nthpulse/mrom64c/README.md

# mrom64c
char and kernal rom replacement for the c64 250469 board

part of the MROM64 project: https://nthpulse.net/projects/mrom64/

details & instruction for this circuit board:
https://nthpulse.net/projects/mrom64/boards/mrom64c/
