nthpulse/mrom64c/MROM64C.kicad_pcb

## KiCad design MROM64C.kicad_pcb (2026-03-04)

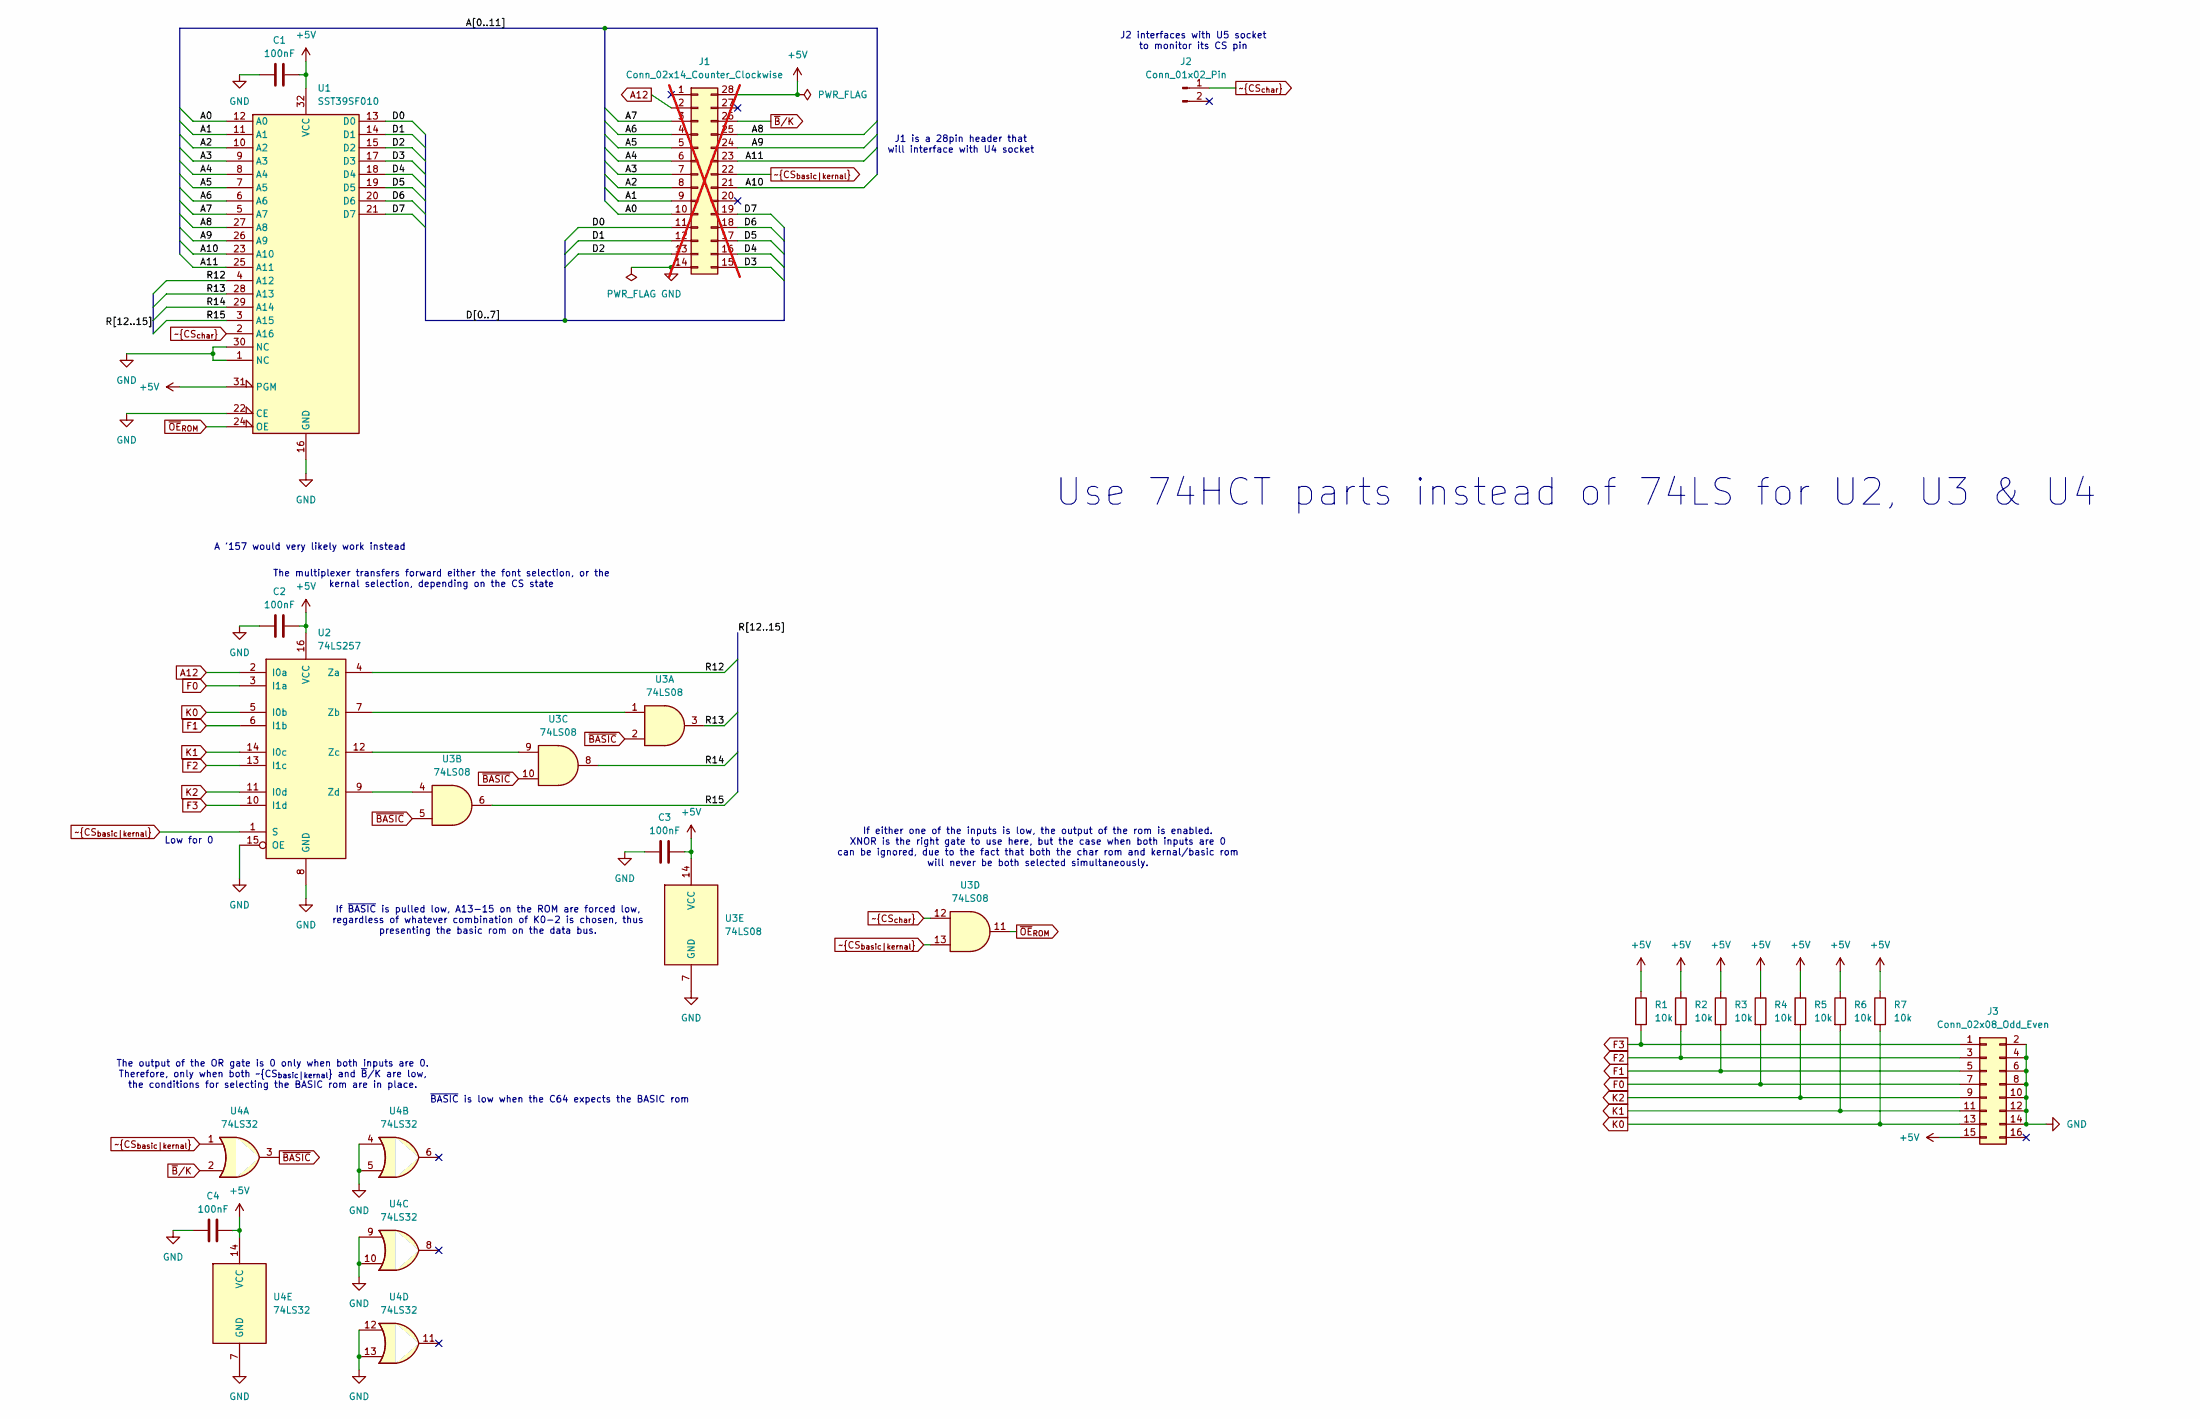
[picture p1: schematic MROM64C.kicad_sch]

Parts:
C1, C2, C3, C4: 100nF; C_0805_2012Metric_Pad1.18x1.45mm_HandSolder
J1: Conn_02x14_Counter_Clockwise; DIP-28_W15.24mm; not fitted
J2: Conn_01x02_Pin; PinHeader_1x02_P2.54mm_Vertical
J3: Conn_02x08_Odd_Even; PinHeader_2x08_P2.54mm_Vertical
R1, R2, R3, R4, R5, R6, R7: 10k; R_0805_2012Metric_Pad1.15x1.40mm_HandSolder
U1: SST39SF010; DIP-32_W15.24mm_Socket
U2: 74LS257; SOIC-16_3.9x9.9mm_P1.27mm
U3: 74LS08; SOIC-14_3.9x8.7mm_P1.27mm
U4: 74LS32; SOIC-14_3.9x8.7mm_P1.27mm

Connections:
+5V: C1.2, C2.2, C3.2, C4.2, J1.28, J3.15, R1.1, R2.1, R3.1, R4.1, R5.1, R6.1, R7.1, U1.31 (PGM), U1.32 (VCC), U2.16 (VCC), U3.14 (VCC), U4.14 (VCC)
/A0: J1.10, U1.12 (A0)
/A1: J1.9, U1.11 (A1)
/A2: J1.8, U1.10 (A2)
/A3: J1.7, U1.9 (A3)
/A4: J1.6, U1.8 (A4)
/A5: J1.5, U1.7 (A5)
/A6: J1.4, U1.6 (A6)
/A7: J1.3, U1.5 (A7)
/A8: J1.25, U1.27 (A8)
/A9: J1.24, U1.26 (A9)
/A10: J1.21, U1.23 (A10)
/A11: J1.23, U1.25 (A11)
/D0: J1.11, U1.13 (D0)
/D1: J1.12, U1.14 (D1)
/D2: J1.13, U1.15 (D2)
/D3: J1.15, U1.17 (D3)
/D4: J1.16, U1.18 (D4)
/D5: J1.17, U1.19 (D5)
/D6: J1.18, U1.20 (D6)
/D7: J1.19, U1.21 (D7)
/R12: U1.4 (A12), U2.4 (Za)
/R13: U1.28 (A13), U3.3
/R14: U1.29 (A14), U3.8
/R15: U1.3 (A15), U3.6
A12: J1.2, U2.2 (I0a)
F0: J3.7, R4.2, U2.3 (I1a)
F1: J3.5, R3.2, U2.6 (I1b)
F2: J3.3, R2.2, U2.13 (I1c)
F3: J3.1, R1.2, U2.10 (I1d)
GND: C1.1, C2.1, C3.1, C4.1, J1.14, J3.2, J3.4, J3.6, J3.8, J3.10, J3.12, J3.14, U1.1 (NC), U1.16 (GND), U1.22 (CE), U1.30 (NC), U2.8 (GND), U2.15 (OE), U3.7 (GND), U4.4, U4.5, U4.7 (GND), U4.9, U4.10, U4.12, U4.13
K0: J3.13, R7.2, U2.5 (I0b)
K1: J3.11, R6.2, U2.14 (I0c)
K2: J3.9, R5.2, U2.11 (I0d)
unnamed: U2.7 (Zb), U3.1
unnamed: U2.12 (Zc), U3.9
unnamed: U2.9 (Zd), U3.4
~BASIC: U3.2, U3.5, U3.10, U4.3
~B/K: J1.26, U4.2
~CS_{basic|kernal}: J1.22, U2.1 (S), U3.13, U4.1
~CS_{char}: J2.1, U1.2 (A16), U3.12
~OE_{ROM}: U1.24 (OE), U3.11

Notes on the sheet:
If either one of the inputs is low, the output of the rom is enabled. XNOR is the right gate to use here, but the case when both inputs are 0 can be ignored, due to the fact that both the char rom and kernal/basic rom will never be both selected simultaneously.
J2 interfaces with U5 socket to monitor its CS pin
The output of the OR gate is 0 only when both inputs are 0. Therefore, only when both ~{CS_{basic|kernal}} and ~{B}/K are low, the conditions for selecting the BASIC rom are in place.
~{BASIC} is low when the C64 expects the BASIC rom
If ~{BASIC} is pulled low, A13-15 on the ROM are forced low, regardless of whatever combination of K0-2 is chosen, thus presenting the basic rom on the data bus.
Use 74HCT parts instead of 74LS for U2, U3 & U4
A '157 would very likely work instead
Low for 0
J1 is a 28pin header that will interface with U4 socket
The multiplexer transfers forward either the font selection, or the kernal selection, depending on the CS state

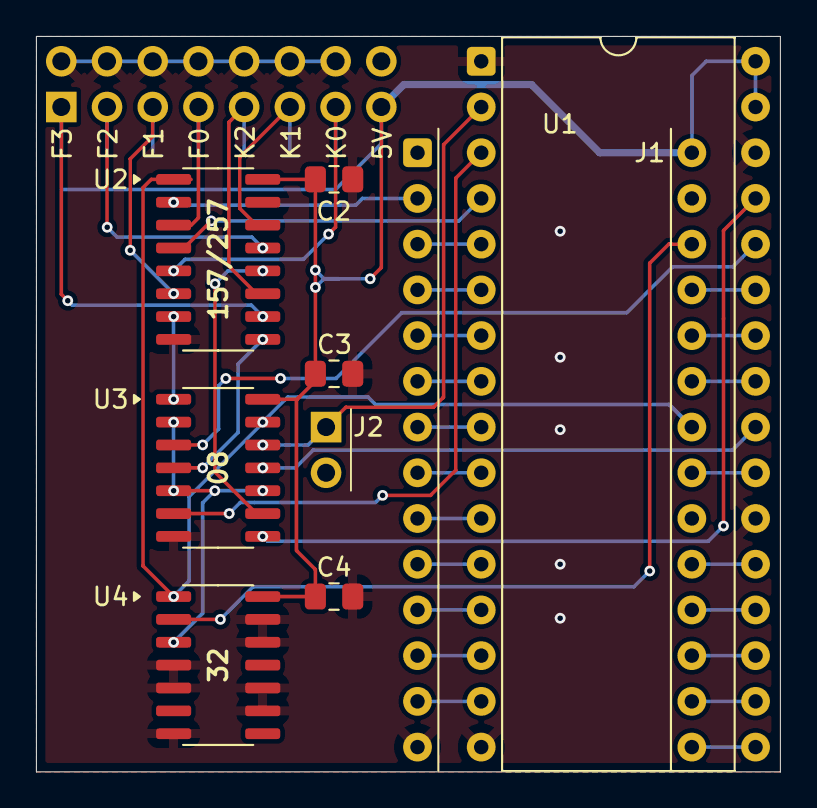
[picture p2: board MROM64C.kicad_pcb from above]

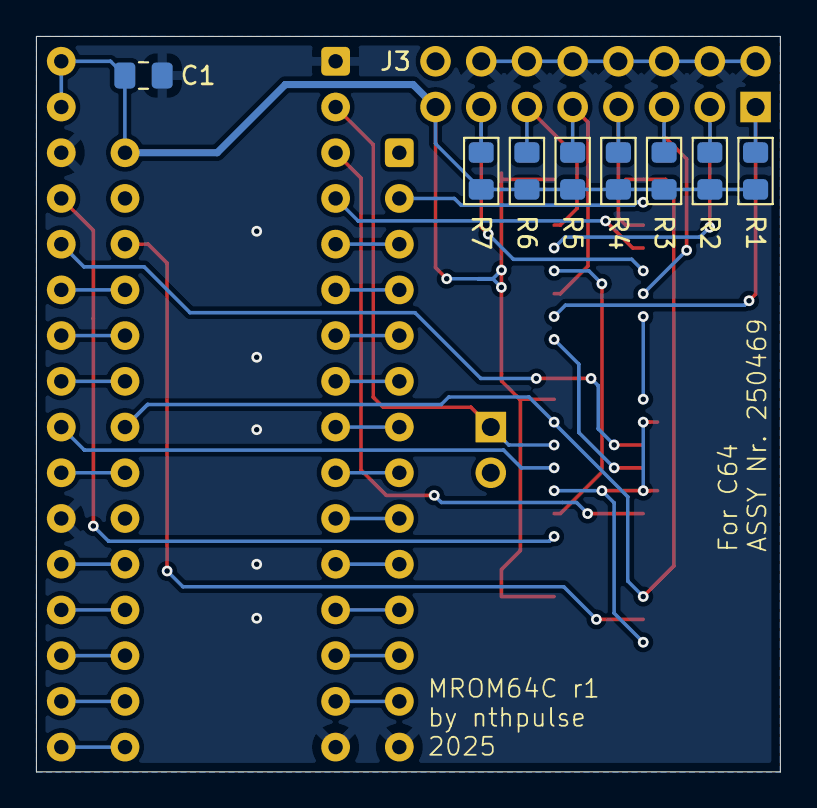
[picture p3: board MROM64C.kicad_pcb from below]

Board: 2 copper layers, 41.3 x 40.9 mm, 18 parts (9 on the bottom side), 42 nets.
